syedawaisr/FYP/FYP/esp32/updated/HC-05_Bluetooth_Interfacing.jpg

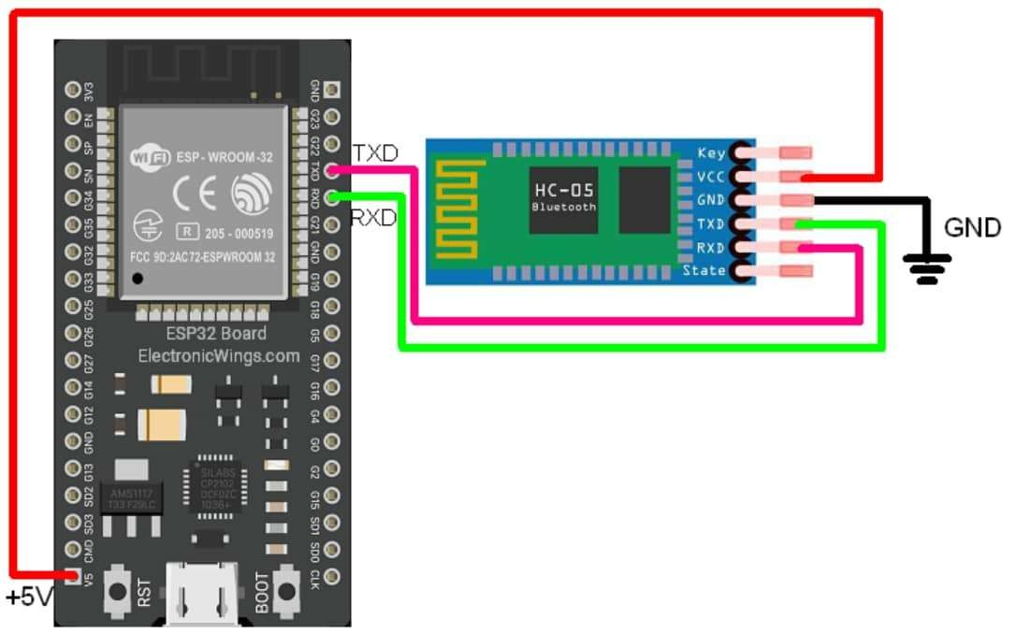
FYP/esp32/updated/HC-05_Bluetooth_Interfacing.jpg
