syedawaisr/FYP/FYP/yolo output.png

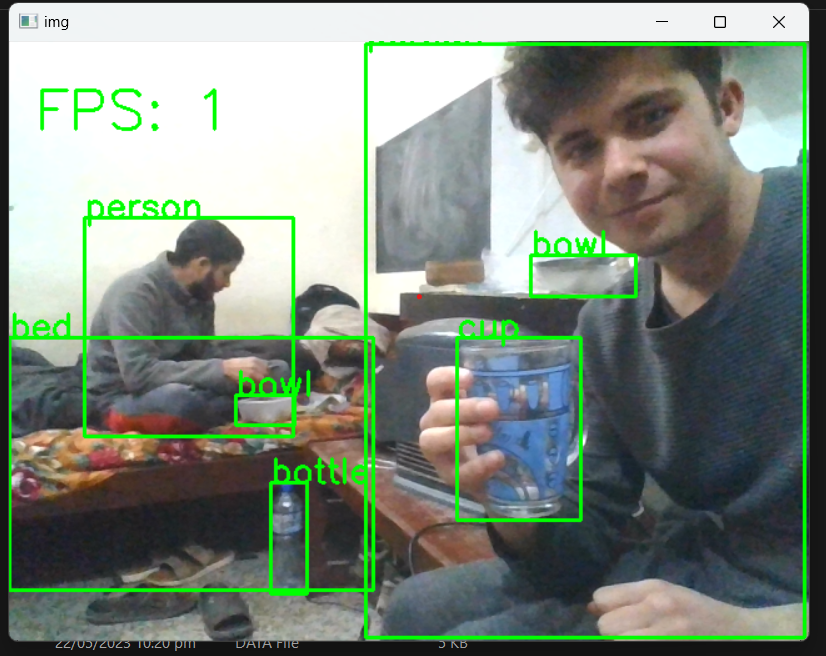
FYP/yolo output.png
