syedawaisr/FYP/README.md

# FYP
This repo contains final year project files which was titled as "Intelligent path planning for self-driving vehicles"
