syedawaisr/FYP/FYP/Mid Presentation/FYP_Mid_Defence_Presentation_Sample.pptx

## Project Tiltle

Name of Supervisor/s
Group Member/s

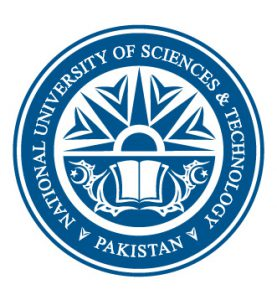
[picture p8: figure]
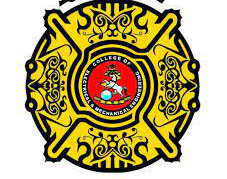
[picture p9: figure]

## Layout

- Introduction
- Block Diagram/ Flow Chart
- Task(s) Assigned to each Group Member
- Tasks Achieved
- Tasks Remaining
- Software and Hardware Part
- Timeline/ Gantt Chart (Old and revised)
- Conclusion
- Q & A
- References
