syedawaisr/FYP/FYP/esp32/Project main/Project Documentation/Abstract.docx

Abstract—

The main aim of this project is to construct a remotely controlled vehicle using microcontroller (ESP32). The vehicle will be connected to a smartphone and will be controlled using the built-in gyroscope.

The vehicle will be using 4 motors, one for each wheel, making it a 4-wheel drive. We’ll be using a 3D printed platform for the base of the vehicle. We’ll be using a motor controller to control all 4 motors. This controller will be directly connected and interfaced with the microcontroller.

We’ll be controlling the direction of the vehicle using the built-in gyroscope of the phone. Tilting the phone will move the vehicle into the corresponding direction.

We’ll be using the application called Blynk IoT to connect the microcontroller to our phone and provide interface for the user to control the vehicle.

The vehicle will also be equipped with anti-collision mechanism. It will use --- to measure the distance between the vehicle and nearby objects.

A rechargeable battery will provide power to the vehicle.

All connections will be made on a breadboard except the communication between microcontroller and the smartphone.
