syedawaisr/FYP/FYP/esp32/Project main/Part Documentation/ESP32 PinOuts.pdf

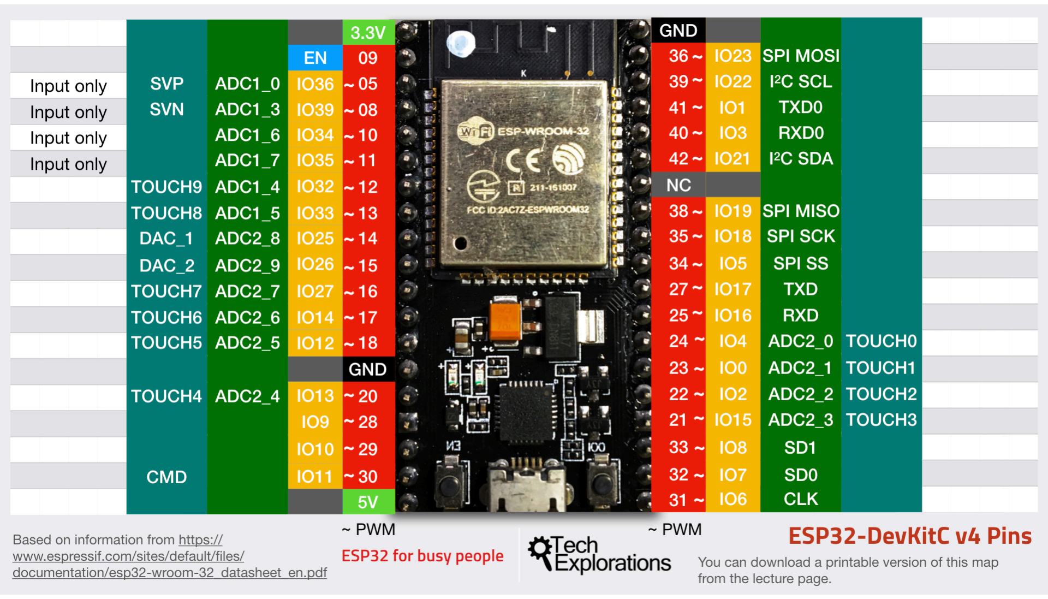
[picture p48: page 1]
