syedawaisr/FYP/FYP/esp32/Project main/Project Documentation/Project Report/Blynk Interface.jpeg

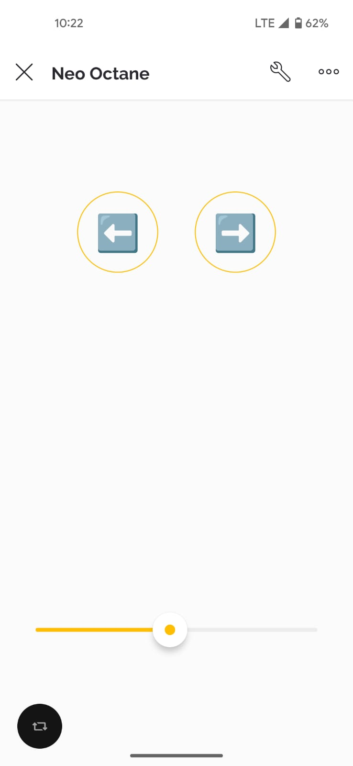
FYP/esp32/Project main/Project Documentation/Project Report/Blynk Interface.jpeg
