syedawaisr/FYP/FYP/esp32/Project main/Project Documentation/Project Report/Dabble Interface.png

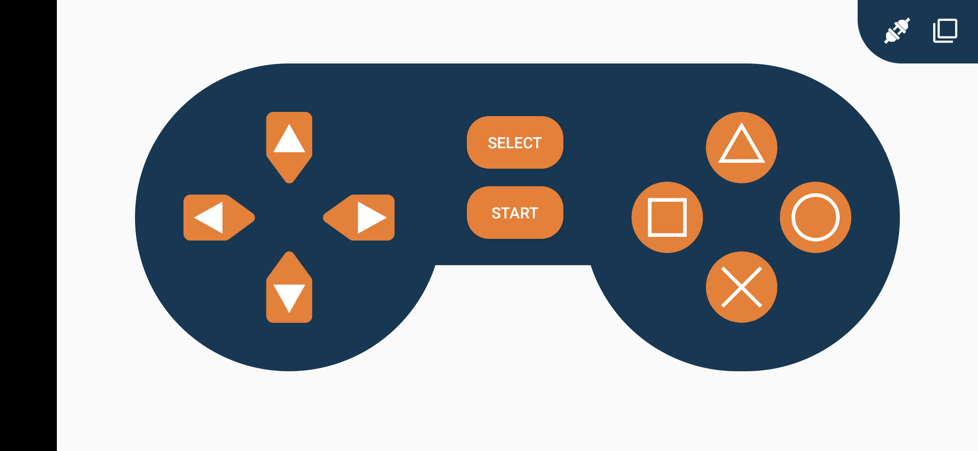
FYP/esp32/Project main/Project Documentation/Project Report/Dabble Interface.png
