syedawaisr/FYP/FYP/esp32/Project main/Project Documentation/Project Report/Simulation.jpeg

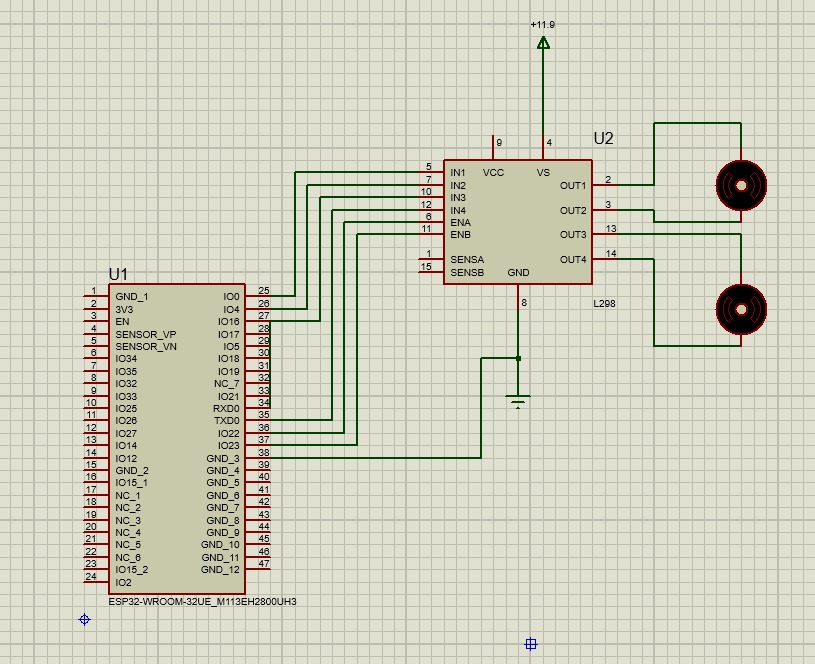
FYP/esp32/Project main/Project Documentation/Project Report/Simulation.jpeg
