syedawaisr/FYP/FYP/esp32/updated/BTS 7960.png

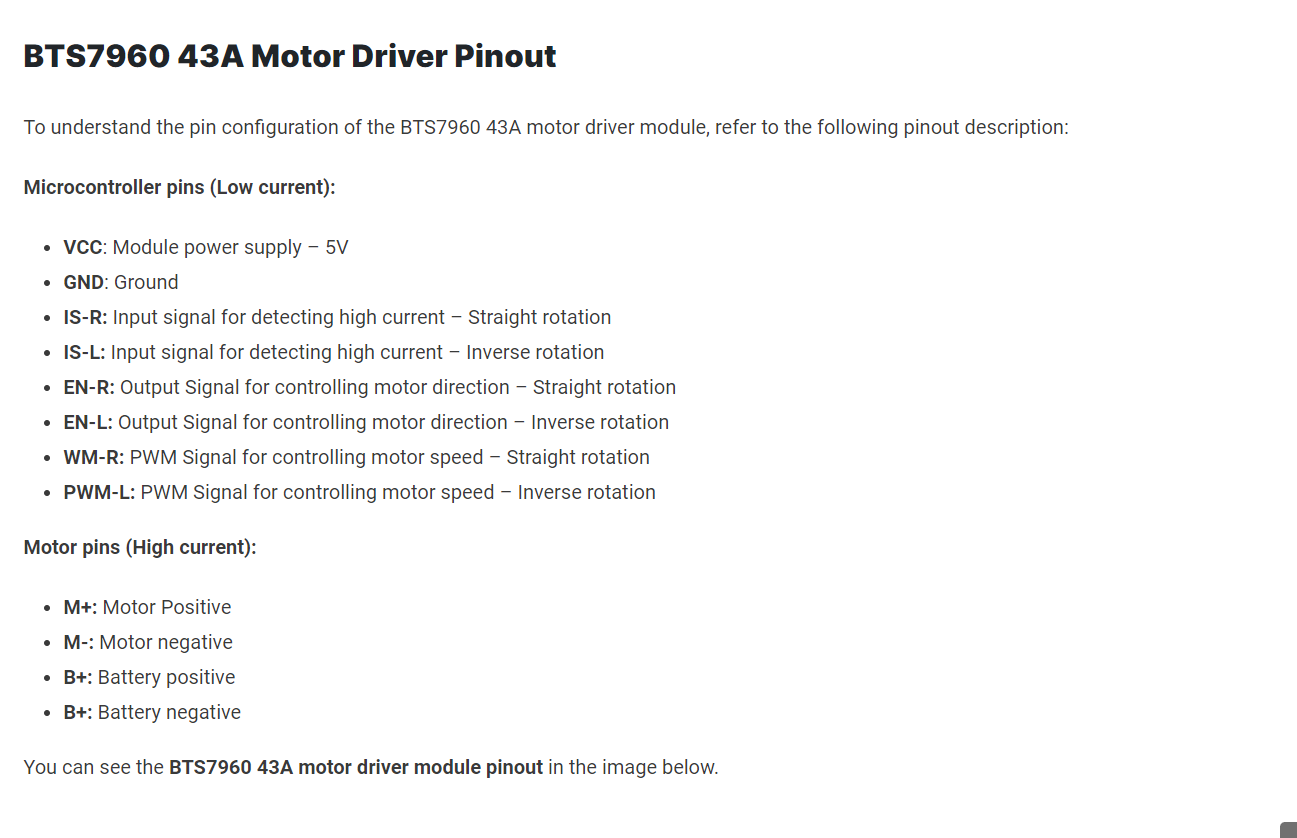
FYP/esp32/updated/BTS 7960.png
