syedawaisr/FYP/FYP/esp32/updated/L298.png

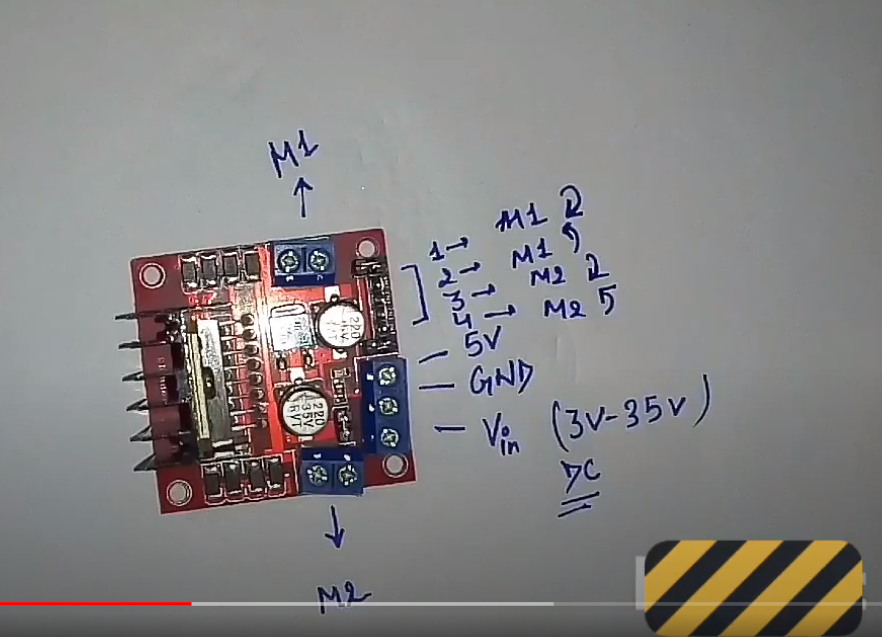
FYP/esp32/updated/L298.png
