syedawaisr/FYP/FYP/fypchart0.png

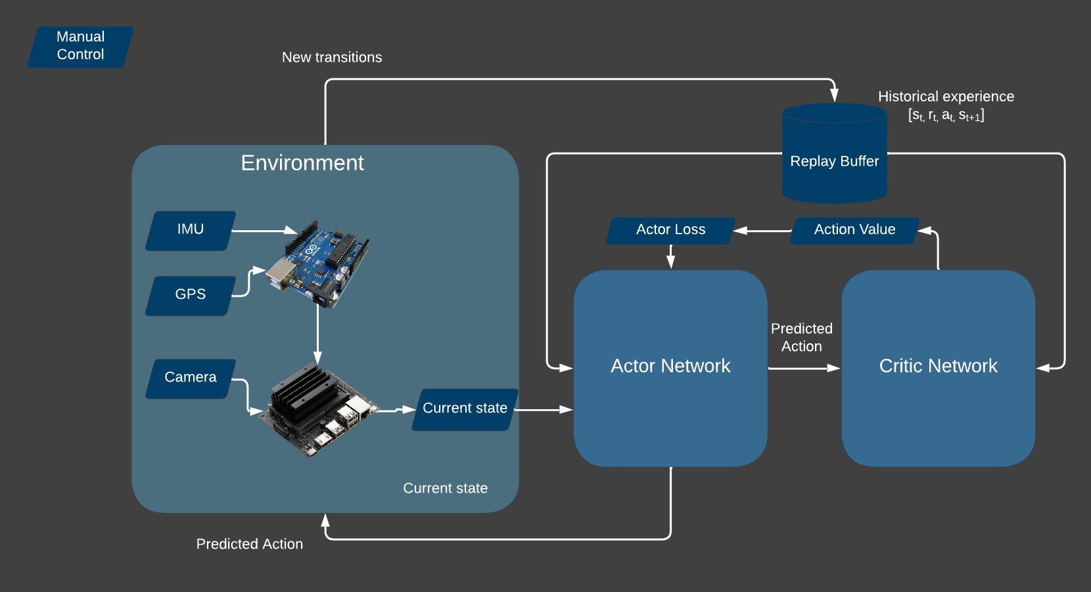
FYP/fypchart0.png
