syedawaisr/FYP/FYP/fypchart5.png

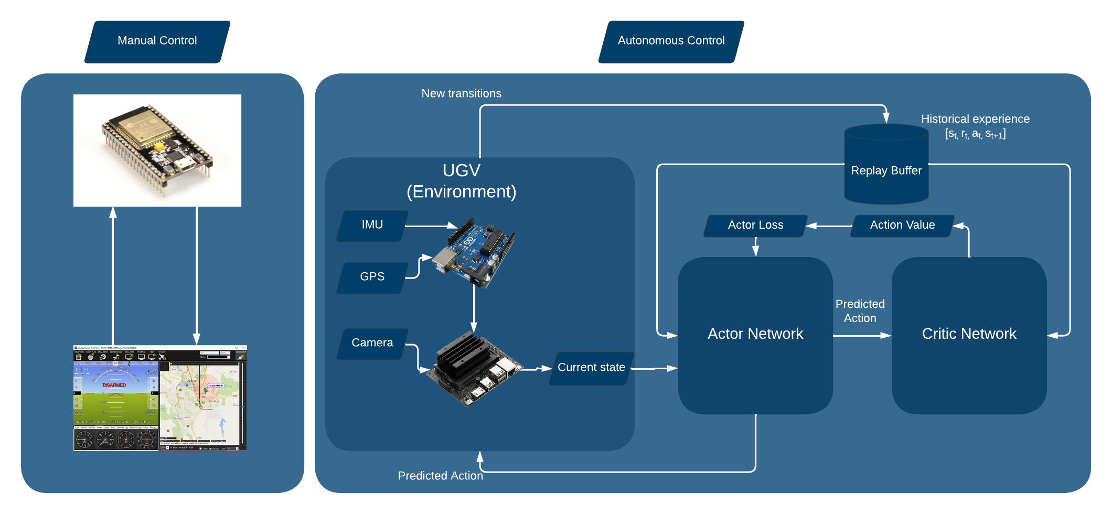
FYP/fypchart5.png
