syedawaisr/FYP/FYP/fypchart (1).png

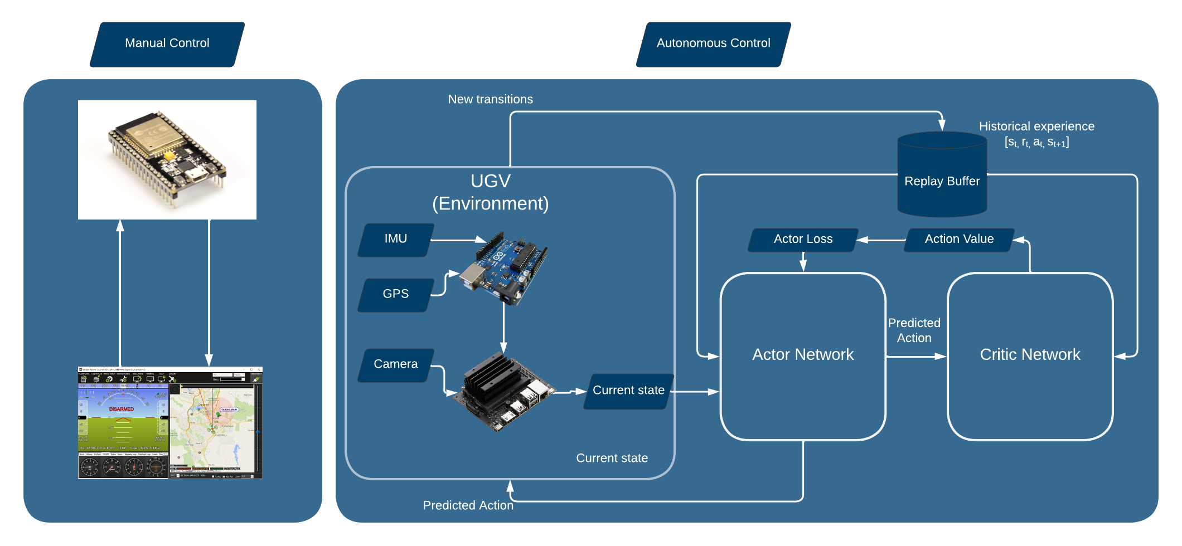
FYP/fypchart (1).png
