syedawaisr/FYP/FYP/live_stream_mission_planner output.png

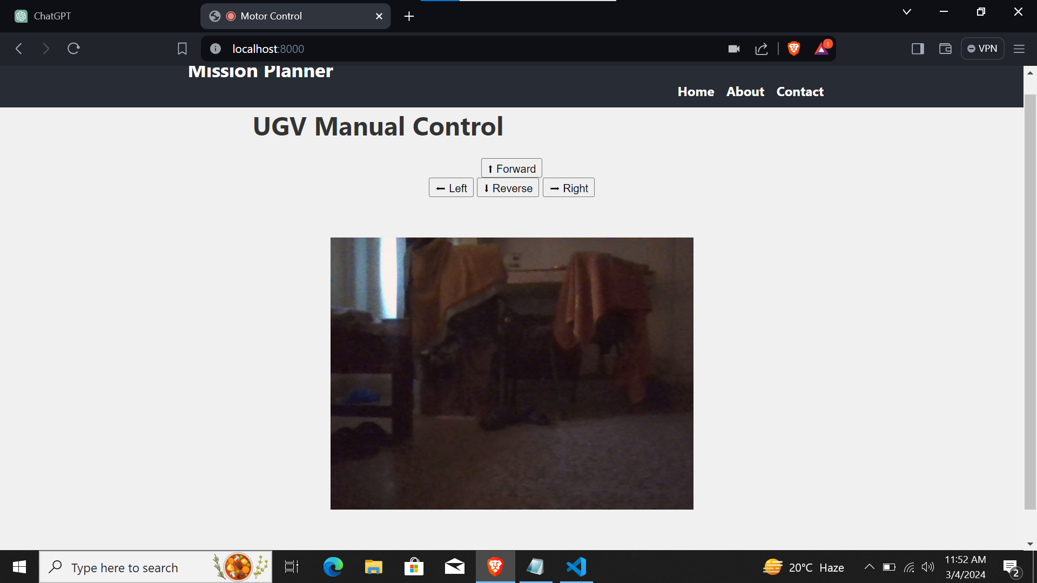
FYP/live_stream_mission_planner output.png
