syedawaisr/FYP/FYP/object detection code/WIN_20240115_18_37_50_Pro.jpg

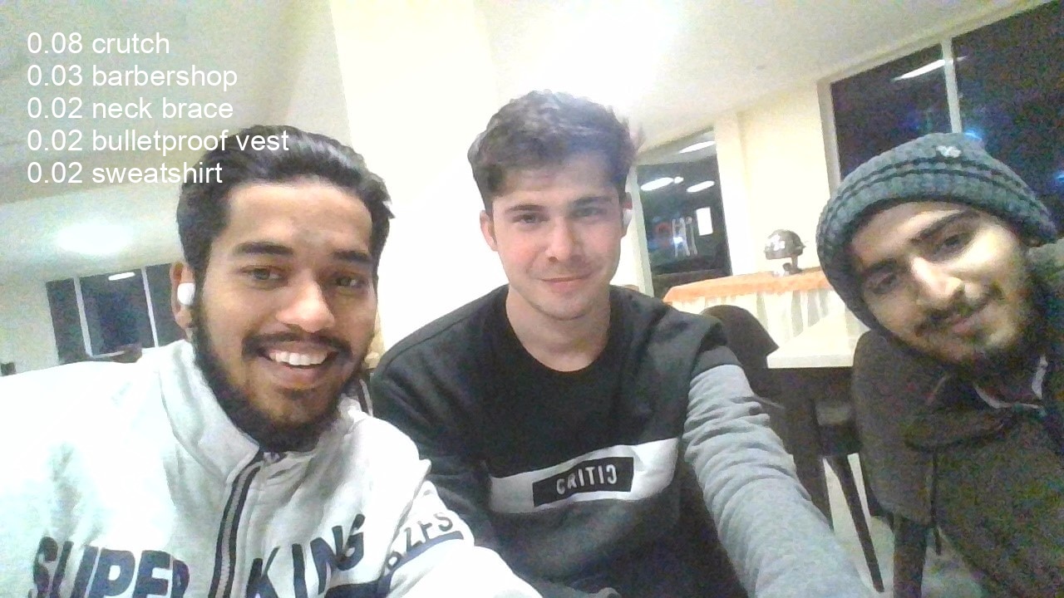
FYP/object detection code/WIN_20240115_18_37_50_Pro.jpg
