syedawaisr/FYP/FYP/Screenshot (161).png

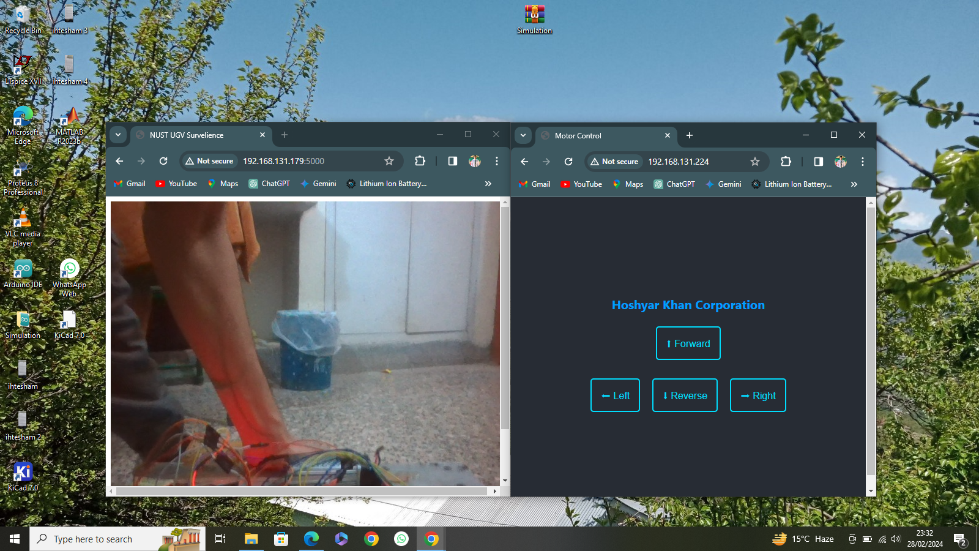
FYP/Screenshot (161).png
