syedawaisr/FYP/(list of files, drawings)

Other design files:
FYP/esp32/Project main/Simulation/Project Backups/Simulation [20221224, 14-51-31].pdsprj
FYP/esp32/Project main/Simulation/Project Backups/Simulation [20221224, 15-00-33].pdsprj
FYP/esp32/Project main/Simulation/Project Backups/Simulation [20221224, 15-07-17].pdsprj
FYP/esp32/Project main/Simulation/Project Backups/Simulation [20221224, 15-38-37].pdsprj
FYP/esp32/Project main/Simulation/Project Backups/Simulation [20221224, 15-39-25].pdsprj
FYP/esp32/Project main/Simulation/Project Backups/Simulation [20221224, 16-16-16].pdsprj
FYP/esp32/Project main/Simulation/Project Backups/Simulation [20230115, 19-11-01].pdsprj
FYP/esp32/Project main/Simulation/Project Backups/Simulation [20230115, 20-02-22].pdsprj
FYP/esp32/Project main/Simulation/Proteus Libraries/Infrared Sensor Library for Proteus/Infrared Sensor Simulation.DSN
FYP/esp32/Project main/Simulation/Simulation.pdsprj
