syedawaisr/FYP/FYP/esp32/Project main/Sketches/Main/v1-0/v1-0.ino

// v1.0
// basic functionalities of a remote controlled car

#define BLYNK_TEMPLATE_ID           "TMPLYZBgCgmc"
#define BLYNK_DEVICE_NAME           "Neo Octane"
#define BLYNK_AUTH_TOKEN            "ZQdrb8G-fOGdpSl7F-728eabn2iXfZMO"
#define BLYNK_PRINT Serial
#define CUSTOM_SETTINGS
#define INCLUDE_SENSOR_MODULE

#include <DabbleESP32.h>
#include <L298NX2.h>
#include <WiFi.h>
#include <WiFiClient.h>
#include <BlynkSimpleEsp32.h>

TaskHandle_t Comms;
char auth[] = BLYNK_AUTH_TOKEN;
// Set password to "" for open networks.
char ssid[] = "SaadRasheed";
char pass[] = "12345678";

#define ENA 2
#define ENB 4
#define IN1 16
#define IN2 17
#define IN3 5
#define IN4 18

#define upperThresh 8.5
#define lowerThresh 1.5

L298N leftMotors(ENA, IN1, IN2);
L298N rightMotors(ENB, IN3, IN4);
int forward = 0;
int backward = 0;
int speed = 0;
double yaxis = 0;

int rightSpeed = 0;
int leftSpeed = 0;
L298N::Direction leftDirection;
L298N::Direction rightDirection;

BLYNK_WRITE(V0){
  forward = param.asInt();
}

BLYNK_WRITE(V1){
  speed = param.asInt();
}

BLYNK_WRITE(V2){
  backward = param.asInt();
}

void communications(void *){
  for(;;)
  {
    Blynk.run();
    Dabble.processInput();
    yaxis = Sensor.getAccelerometerYaxis();
  }
}

void setup() {
  Serial.begin(115200);
  Blynk.begin(auth, ssid, pass);
  Dabble.begin("MyESP32");

  xTaskCreatePinnedToCore(communications, "Comms", 10000, NULL, 0, &Comms, 0);
}

void directionControl(){

  double offset = 0;
  leftSpeed = speed;
  rightSpeed = speed;
  double y = yaxis;
  
  if (y > lowerThresh && y < upperThresh)
  {
    offset = 27 * (y - lowerThresh);
    leftSpeed += offset;
    rightSpeed -= offset;
    leftDirection = L298N::FORWARD;
    rightDirection = L298N::FORWARD; 
  }
  else if (y > -upperThresh && y < -lowerThresh)
  {
    offset = 30 * (y + lowerThresh);
    leftSpeed += offset;
    rightSpeed -= offset;
    leftDirection = L298N::FORWARD;
    rightDirection = L298N::FORWARD;    
  }
  else if (y > upperThresh)
  {
    leftSpeed = 255;
    rightSpeed = 128;
    leftDirection = L298N::FORWARD;
    rightDirection = L298N::BACKWARD;
  }
  else if (y < -upperThresh)
  {
    leftSpeed = 128;
    rightSpeed = 255;
    leftDirection = L298N::BACKWARD;
    rightDirection = L298N::FORWARD;
  }
  
  if (leftSpeed < 70){
    leftSpeed = 70;    
  }
  else if (leftSpeed > 255){
    leftSpeed = 255;
  }
  
  if (rightSpeed < 70){
    rightSpeed = 70;    
  }
  else if (rightSpeed > 255){
    rightSpeed = 255;
  }
  if (backward == 1 && forward == 0)
  {
    if (leftDirection == L298N::BACKWARD) {leftDirection = L298N::FORWARD;} else {leftDirection = L298N::BACKWARD;}
    if (rightDirection == L298N::BACKWARD) {rightDirection = L298N::FORWARD;} else {rightDirection = L298N::BACKWARD;}
  }
}

void motorControl(){
  if ((forward == 1 && backward == 0) || (forward == 0 && backward == 1))
  {
    rightMotors.setSpeed(rightSpeed);
    leftMotors.setSpeed(leftSpeed);
    rightMotors.run(leftDirection);
    leftMotors.run(rightDirection);        
  }
  else
  {
    leftMotors.stop();
    rightMotors.stop();
  }
}

void loop() {
  directionControl();
  motorControl();
}
